Terionnn/Wykorzystanie-mikrokontrolera-w-ukladzie-pozyskiwania-energii-z-promieniowania-slonecznego/I-V.png

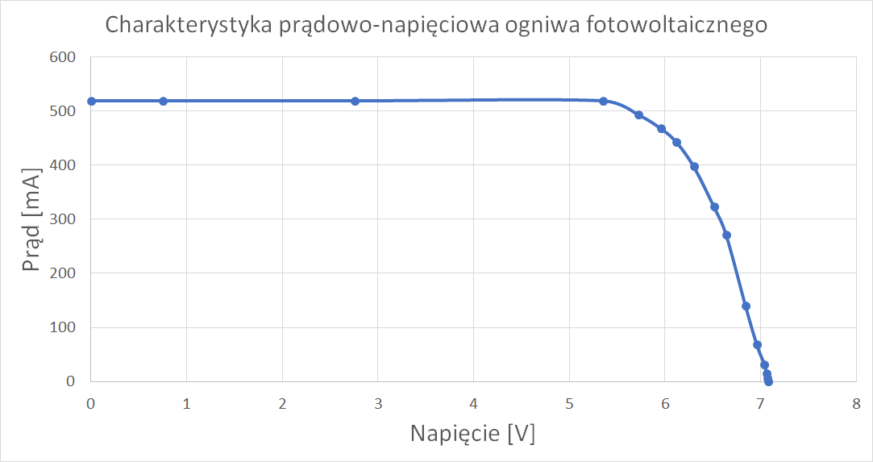
I-V.png
