Terionnn/Wykorzystanie-mikrokontrolera-w-ukladzie-pozyskiwania-energii-z-promieniowania-slonecznego/prąd-natężenie.png

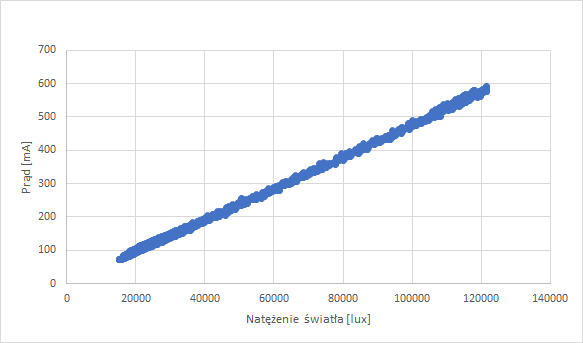
prąd-natężenie.png
