Terionnn/Wykorzystanie-mikrokontrolera-w-ukladzie-pozyskiwania-energii-z-promieniowania-slonecznego/Qt/solar.png

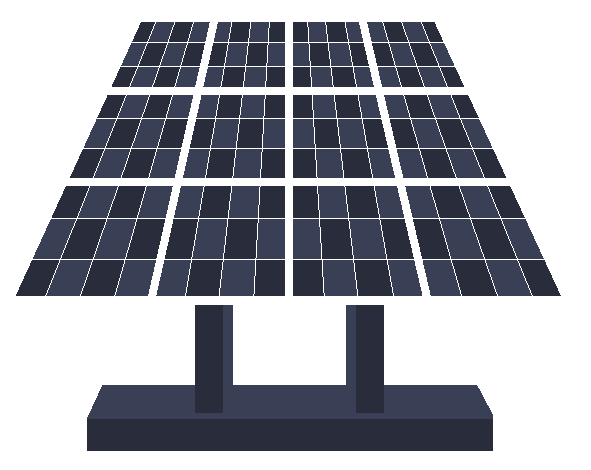
Qt/solar.png
