Terionnn/Wykorzystanie-mikrokontrolera-w-ukladzie-pozyskiwania-energii-z-promieniowania-slonecznego/(list of files, cad)

Other CAD files:
Inventor/obudowa.ipt
Inventor/podstawa.ipt
Inventor/podstawka.ipt
Inventor/pokrywa.ipt
Inventor/ramie_1.ipt
Inventor/ramie_2.ipt
Inventor/tuleja_1.ipt
Inventor/tuleja_2.ipt
Inventor/uchwyt_1.ipt
Inventor/uchwyt_2.ipt
Inventor/zaślepka.ipt
