Terionnn/Wykorzystanie-mikrokontrolera-w-ukladzie-pozyskiwania-energii-z-promieniowania-slonecznego/STM32CubeIDE/Core/Src/main.c

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
/* Includes ------------------------------------------------------------------*/
#include "main.h"

/* USER CODE BEGIN Includes */
#include "string.h"
#include <stdio.h>
#include "bh1750_driver.h"
#include "ina219_driver.h"
#include "stdlib.h"
/* USER CODE END Includes */

 ADC_HandleTypeDef hadc1;
DMA_HandleTypeDef hdma_adc1;

I2C_HandleTypeDef hi2c1;
I2C_HandleTypeDef hi2c2;

TIM_HandleTypeDef htim1;
TIM_HandleTypeDef htim2;
TIM_HandleTypeDef htim3;

UART_HandleTypeDef huart2;
DMA_HandleTypeDef hdma_usart2_rx;
DMA_HandleTypeDef hdma_usart2_tx;

void SystemClock_Config(void);
static void MX_GPIO_Init(void);
static void MX_DMA_Init(void);
static void MX_USART2_UART_Init(void);
static void MX_ADC1_Init(void);
static void MX_I2C1_Init(void);
static void MX_TIM1_Init(void);
static void MX_I2C2_Init(void);
static void MX_TIM2_Init(void);
static void MX_TIM3_Init(void);
/* USER CODE BEGIN 0 */
uint8_t servo_ctrl[2];
uint32_t ADCbuff[3];
volatile int rotate_right = 0;
volatile int rotate_left = 0;
volatile int is_rotating = 0;

//servo 1 speed control
void change_speed_1(int value)
{
    htim1.Instance->CCR1=value;
}

//servo 2 speed control
void change_speed_2(int value)
{
    htim1.Instance->CCR2=value;
}


void measure_and_send()
{
    uint32_t illuminance = BH1750_GetIlluminance();
    double current = (double)INA219_ReadCurrent() * 0.04;
    double voltage = 3.08* 3.30/4096.00 *(double)ADCbuff[0];

    char value_1[5];
    char value_2[6];
    char value_3[8];
    char data_frame[17];

    snprintf(value_1, sizeof(value_1), "%.2f", (double)voltage);
    snprintf(value_2, sizeof(value_2), "%.3f", (double)current);
    snprintf(value_3, sizeof(value_3), "%.1f", (double)illuminance);
    snprintf(data_frame, sizeof(data_frame),"%s%s%s", value_1, value_2, value_3);

    printf("%s\n", data_frame);

}
void HAL_TIM_PeriodElapsedCallback(TIM_HandleTypeDef* htim)
{
    if(htim->Instance==TIM2)
    {
        if(is_rotating==1)
        {
            change_speed_1(1520);
            HAL_TIM_PWM_Stop(&htim1, TIM_CHANNEL_1);
            rotate_right=0;
            rotate_left=0;
            is_rotating=0;
        }
        if(rotate_left==1)
        {
            HAL_TIM_PWM_Start(&htim1, TIM_CHANNEL_1);
            change_speed_1(1540);
        	is_rotating=1;
        }
        else if(rotate_right==1)
        {
            HAL_TIM_PWM_Start(&htim1, TIM_CHANNEL_1);
            change_speed_1(1500);
        	is_rotating=1;
        }
        measure_and_send();



    }
    if(htim->Instance==TIM3)
    {
        int diff = ADCbuff[2] - ADCbuff[1];
        if(abs(diff) > 30)
        {
            if(diff < 0)
            {
                rotate_right=1;
            }
            else
            {
                rotate_left=1;
            }
        }
        else
        {
            rotate_left=0;
            rotate_right=0;
        }

    }
}


//redefinition of write fcn
int _write(int file, char *ptr, int len)
{
    HAL_UART_Transmit(&huart2, (uint8_t*) ptr, len, 50);
    return len;
}



/* USER CODE END 0 */

/**
  * @brief  The application entry point.
  * @retval int
  */
int main(void)
{
  /* MCU Configuration--------------------------------------------------------*/

  /* Reset of all peripherals, Initializes the Flash interface and the Systick. */
  HAL_Init();

  /* Configure the system clock */
  SystemClock_Config();

  /* USER CODE BEGIN SysInit */
    MX_DMA_Init();

  /* USER CODE END SysInit */

  /* Initialize all configured peripherals */
  MX_GPIO_Init();
  MX_DMA_Init();
  MX_USART2_UART_Init();
  MX_ADC1_Init();
  MX_I2C1_Init();
  MX_TIM1_Init();
  MX_I2C2_Init();
  MX_TIM2_Init();
  MX_TIM3_Init();
  /* USER CODE BEGIN 2 */
   __HAL_RCC_I2C1_CLK_ENABLE();
   __I2C1_CLK_ENABLE();
   __HAL_RCC_I2C2_CLK_ENABLE();
   __I2C2_CLK_ENABLE();
   HAL_TIM_Base_Start_IT(&htim2);
   HAL_TIM_Base_Start_IT(&htim3);
   HAL_TIM_PWM_Start(&htim1, TIM_CHANNEL_1);
   HAL_TIM_PWM_Start(&htim1, TIM_CHANNEL_2);
   __HAL_UART_ENABLE_IT(&huart2, UART_IT_RXNE);
   __HAL_RCC_ADC1_CLK_ENABLE();
   __HAL_RCC_USART2_CLK_ENABLE();
   HAL_UART_Receive_DMA(&huart2, servo_ctrl, 2);
   HAL_ADC_Start_DMA(&hadc1, ADCbuff, 3);

   BH1750_PowerOn();
   HAL_Delay(200);
   BH1750_SetContinuousMode();
   INA219_Reset();
   HAL_Delay(200);
   INA219_Calibrate();
  /* USER CODE END 2 */

  /* Infinite loop */
  /* USER CODE BEGIN WHILE */
    while (1)
    {
    	if(is_rotating==0 && rotate_left==0 && rotate_right==0)
    	{
        if (servo_ctrl[0]==0)
        {
            change_speed_1(1520);
        }
        else if (servo_ctrl[0]==1)
        {
        	change_speed_1(1540);
            HAL_TIM_PWM_Start(&htim1, TIM_CHANNEL_1);
        }
        else if (servo_ctrl[0]==2)
        {
            change_speed_1(1500);
            HAL_TIM_PWM_Start(&htim1, TIM_CHANNEL_1);
        }

        if (servo_ctrl[1]==0)
        {
            change_speed_2(1535);
            HAL_TIM_PWM_Stop(&htim1, TIM_CHANNEL_2);
        }
        else if (servo_ctrl[1]==1)
        {
            HAL_TIM_PWM_Start(&htim1, TIM_CHANNEL_2);
            change_speed_2(1500);
        }

        else if (servo_ctrl[1]==2)
        {
            HAL_TIM_PWM_Start(&htim1, TIM_CHANNEL_2);
            change_speed_2(1560);
        }


    }
    }
    /* USER CODE END WHILE */

}

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
