Terionnn/Wykorzystanie-mikrokontrolera-w-ukladzie-pozyskiwania-energii-z-promieniowania-slonecznego/STM32CubeIDE/praca_inzynierska.ioc

Mcu.UserName=STM32F411RETx
PA15.Signal=USART1_TX
PA2.Signal=USART2_TX
PA3.Signal=USART2_RX
PA5.Signal=GPIO_Output
PA8.Signal=S_TIM1_CH1
PA9.Signal=S_TIM1_CH2
PB10.Signal=I2C2_SCL
PB3.Signal=I2C2_SDA
PB6.Signal=I2C1_SCL
PB7.Signal=I2C1_SDA
PC13-ANTI_TAMP.Signal=GPIO_Input
PC2.Signal=ADCx_IN12
PC3.Signal=ADCx_IN13
PC5.Signal=ADCx_IN15
PC8.Signal=GPIO_Output
