Terionnn/Wykorzystanie-mikrokontrolera-w-ukladzie-pozyskiwania-energii-z-promieniowania-slonecznego/STM32CubeIDE/Core/Inc/bh1750_driver.h

/*
 * bh1750_driver.h
 *
 *  Created on: 17 sie 2022
 *      Author: Kamil
 *
 *      Na podstawie: https://github.com/lamik/Light_Sensors_STM32
 *
Copyright (c) 2018 Mateusz Salamon <mateusz@msalamon.pl>

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
THE SOFTWARE IS PROVIDED "AS IS", WITHOUT WARRANTY OF ANY KIND, EXPRESS OR
IMPLIED, INCLUDING BUT NOT LIMITED TO THE WARRANTIES OF MERCHANTABILITY,
FITNESS FOR A PARTICULAR PURPOSE AND NONINFRINGEMENT. IN NO EVENT SHALL THE
AUTHORS OR COPYRIGHT HOLDERS BE LIABLE FOR ANY CLAIM, DAMAGES OR OTHER
LIABILITY, WHETHER IN AN ACTION OF CONTRACT, TORT OR OTHERWISE, ARISING FROM,
OUT OF OR IN CONNECTION WITH THE SOFTWARE OR THE USE OR OTHER DEALINGS IN
THE SOFTWARE.
 */

#ifndef INC_BH1750_DRIVER_H_
#define INC_BH1750_DRIVER_H_
#define BH1750_ADDR	(0x23<<1)

void BH1750_PowerOn();
void BH1750_SetContinuousMode();
uint32_t BH1750_GetIlluminance();

#endif
